rw-hsma-fpga/grub-switch/4_misc/3Dprint_Toggleswitch_Stand_STL/Toggleswitch_stand2.jpg

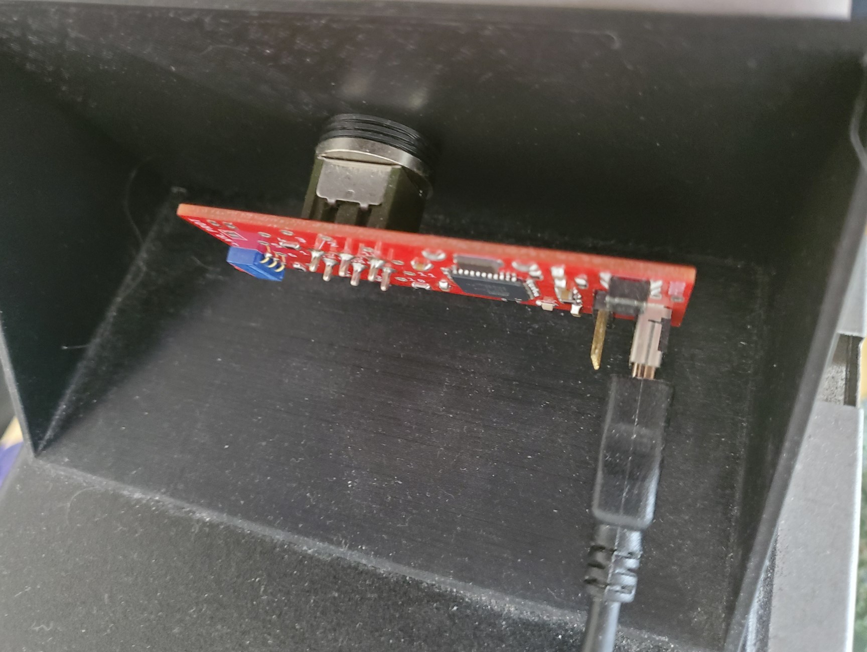
4_misc/3Dprint_Toggleswitch_Stand_STL/Toggleswitch_stand2.jpg
