rw-hsma-fpga/grub-switch/4_misc/ArduinoMicro_Toggleswitch_Fritzing/ArduinoMicro_Toggleswitch_Fritzing.png

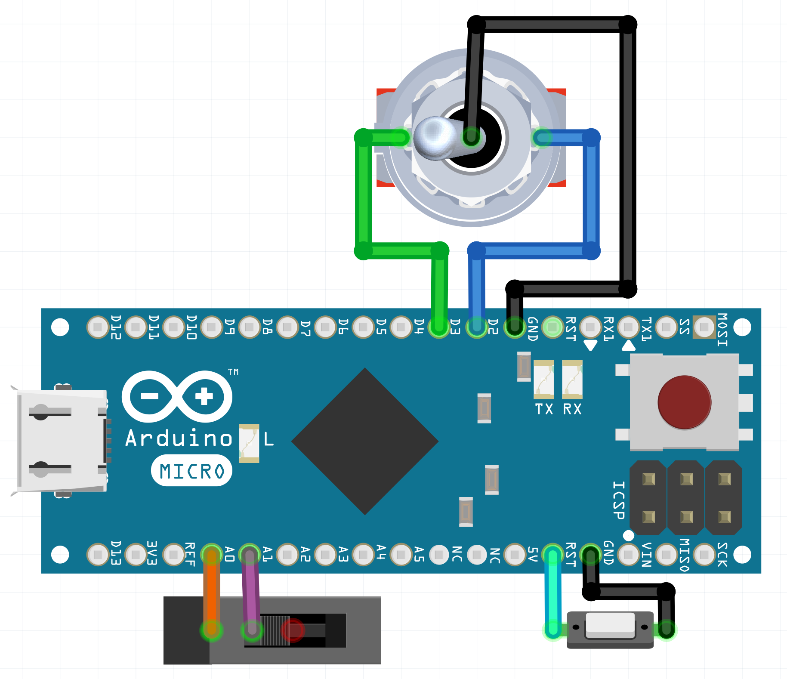
4_misc/ArduinoMicro_Toggleswitch_Fritzing/ArduinoMicro_Toggleswitch_Fritzing.png
