rw-hsma-fpga/grub-switch/4_misc/Lasercut_Case_ProMicro_Toggleswitch_SVG/ProMicro_case2.jpeg

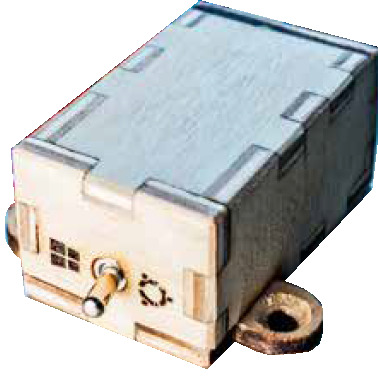
4_misc/Lasercut_Case_ProMicro_Toggleswitch_SVG/ProMicro_case2.jpeg
