rw-hsma-fpga/grub-switch/documentation/src/config_8.png

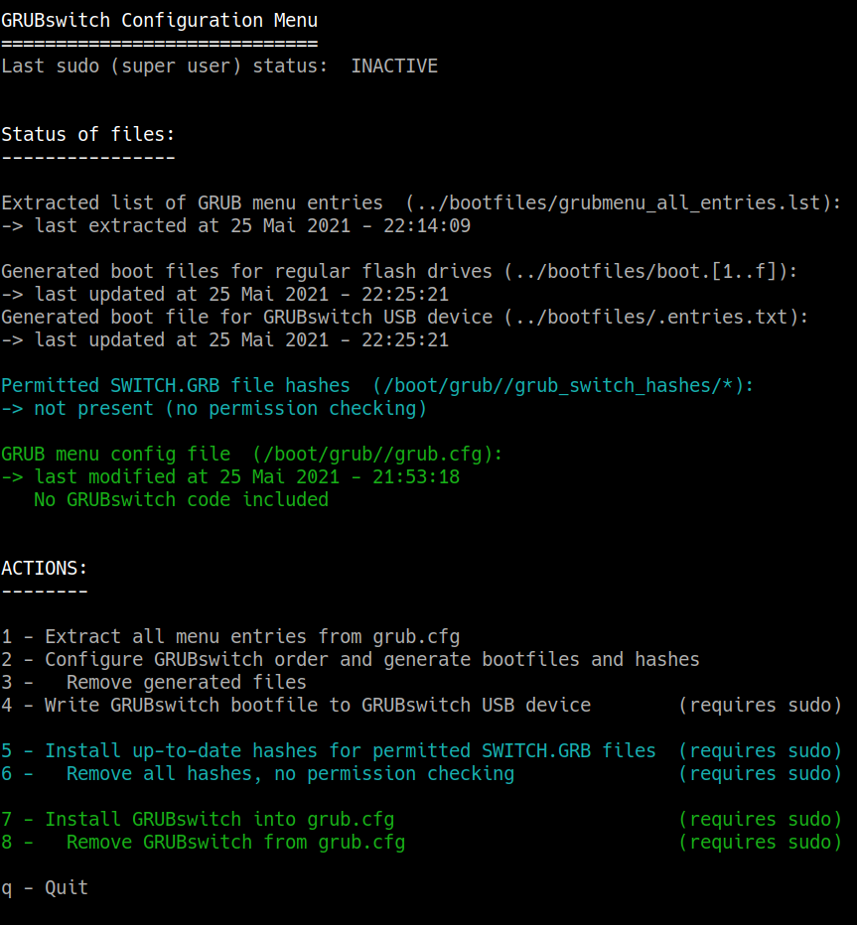
documentation/src/config_8.png
