rw-hsma-fpga/grub-switch/documentation/src/config_10.png

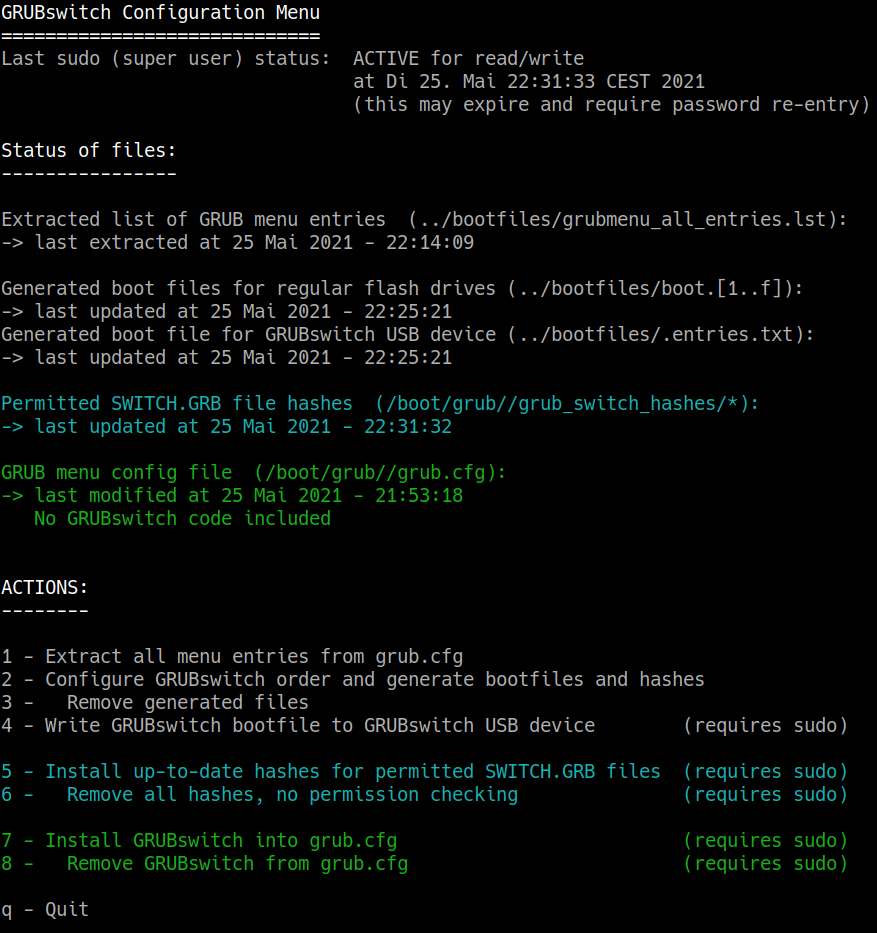
documentation/src/config_10.png
