rw-hsma-fpga/grub-switch/documentation/src/custom_hw_revb_bottom.png

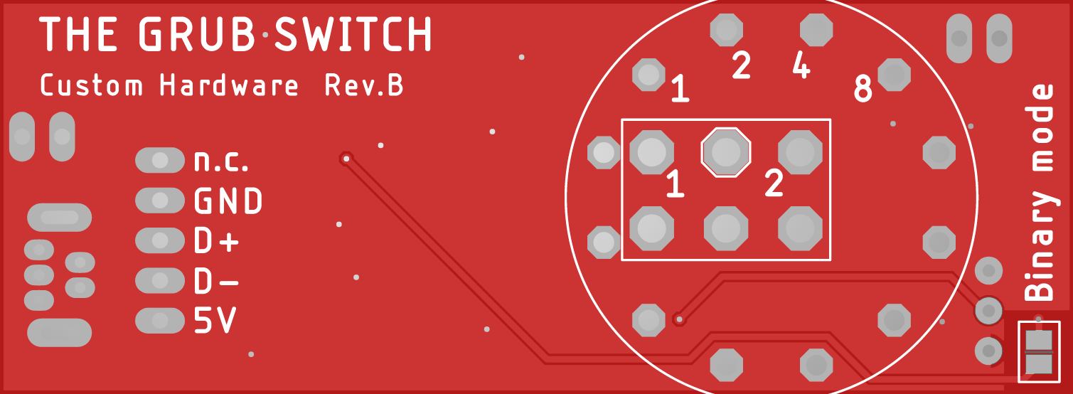
documentation/src/custom_hw_revb_bottom.png
