rw-hsma-fpga/grub-switch/documentation/src/custom_hw_revc_passives_top.png

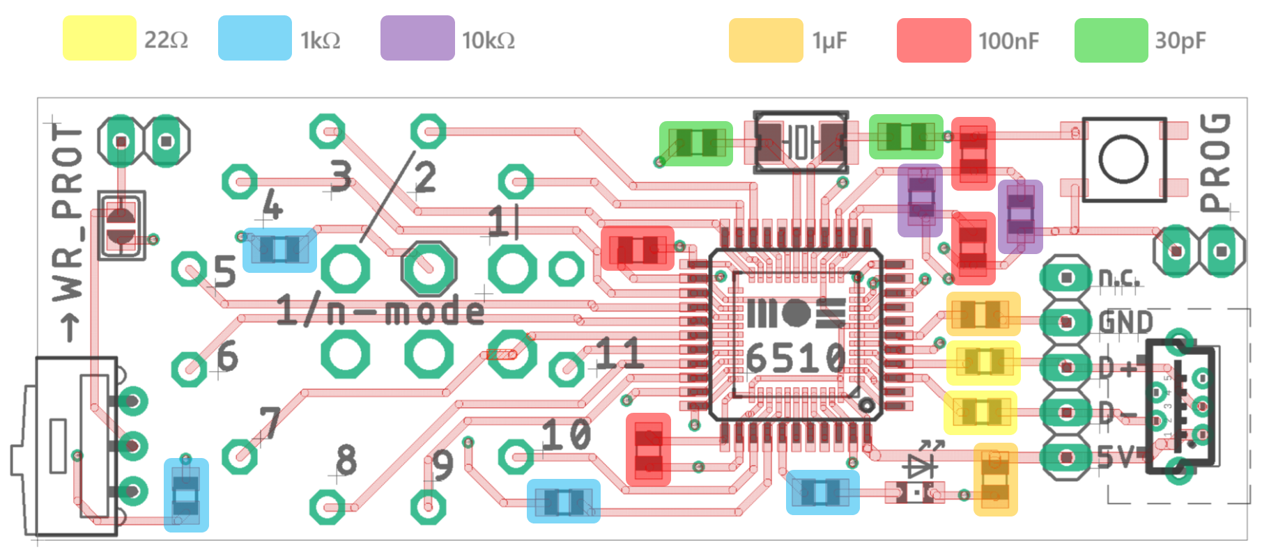
documentation/src/custom_hw_revc_passives_top.png
