rw-hsma-fpga/grub-switch/documentation/src/passives_top.png

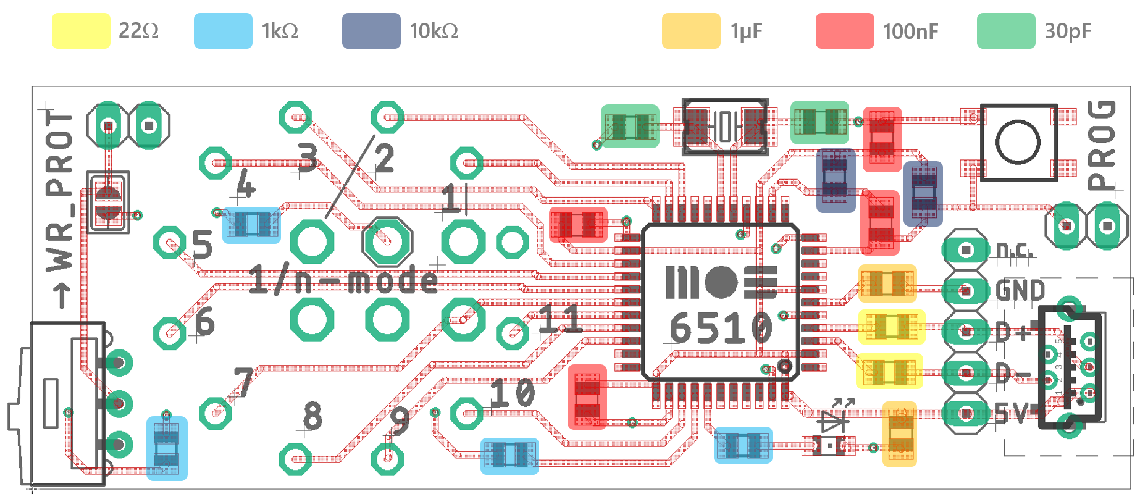
documentation/src/passives_top.png
