rw-hsma-fpga/grub-switch/documentation/src/rotary_sw_bottom.png

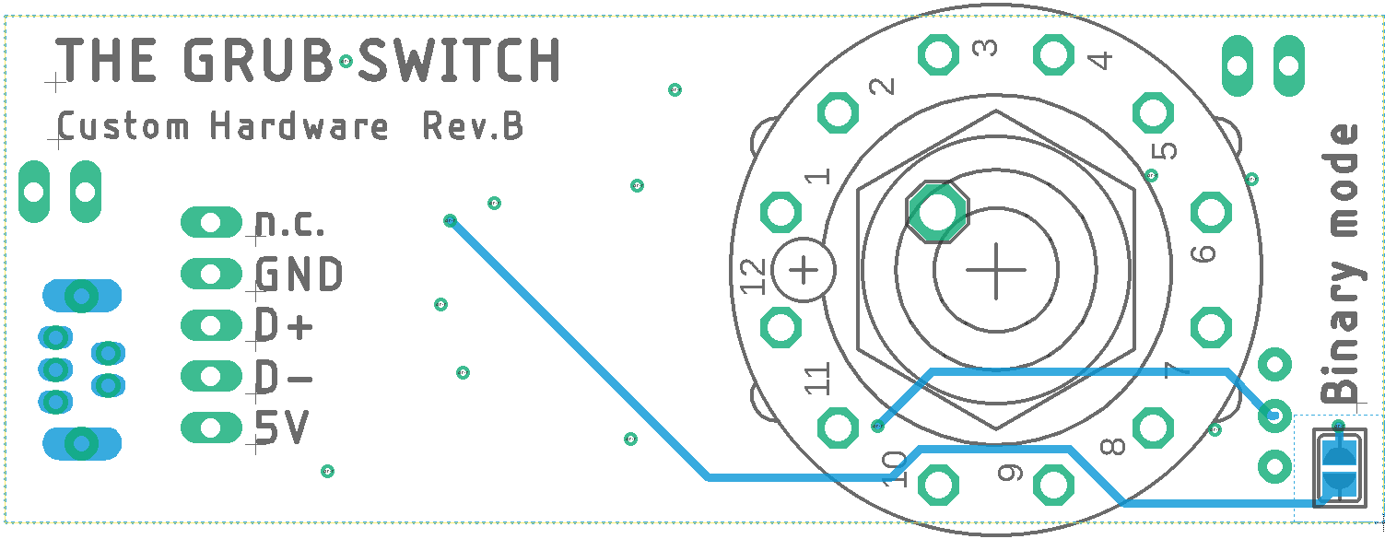
documentation/src/rotary_sw_bottom.png
