rw-hsma-fpga/grub-switch/documentation/src/toggle_sw_bottom.png

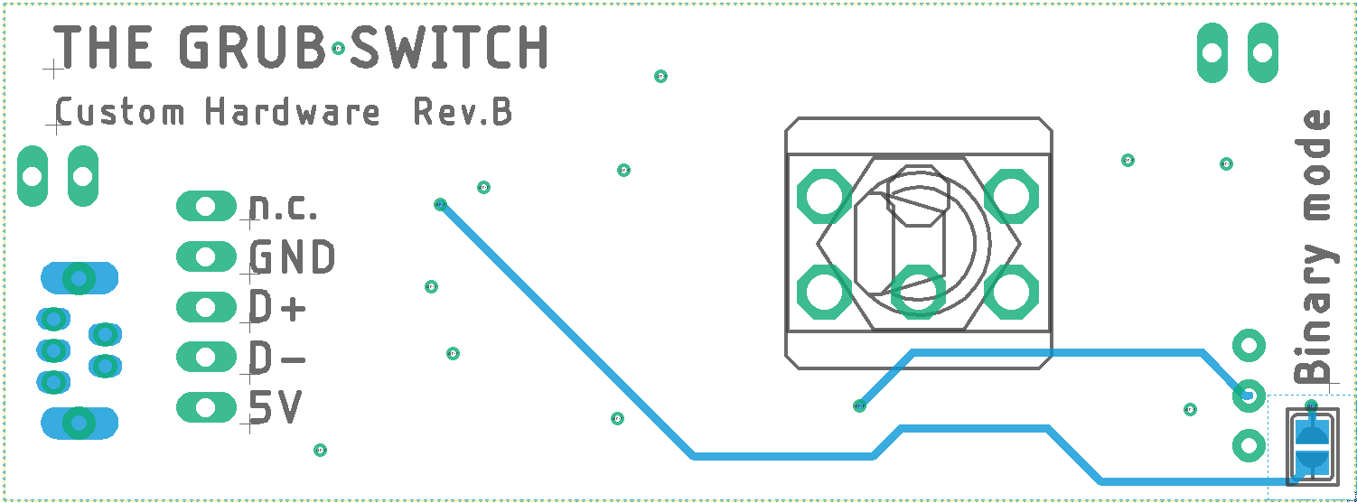
documentation/src/toggle_sw_bottom.png
