rw-hsma-fpga/grub-switch/4_misc/3Dprint_Toggleswitch_Stand_STL/Toggleswitch_stand.stl

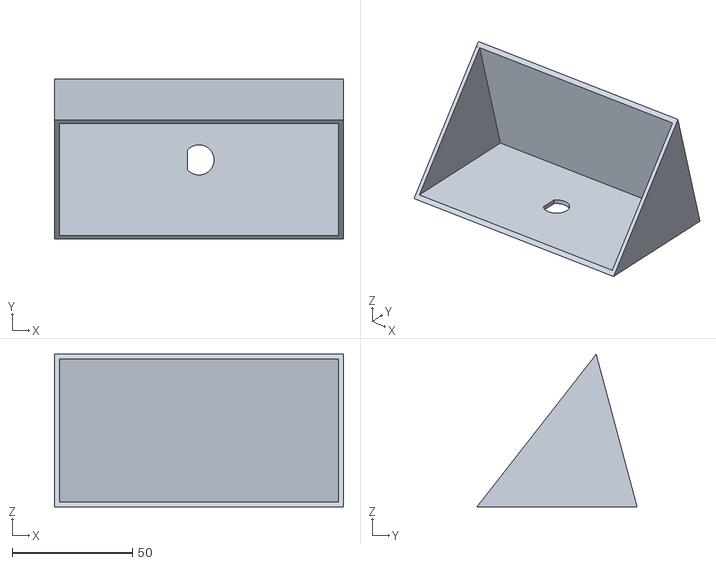
[picture p30: CAD file, 2023-05-13]
4_misc/3Dprint_Toggleswitch_Stand_STL/Toggleswitch_stand.stl
120.0 x 66.5 x 63.4
