rw-hsma-fpga/grub-switch/4_misc/3Dprint_Toggleswitch_Stand_STL/Unterlegscheibe_washer.stl

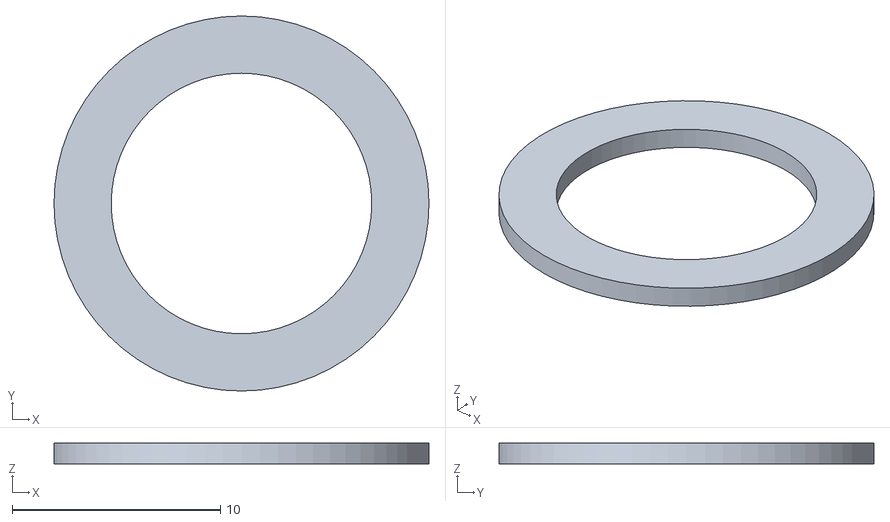
[picture p31: CAD file, 2023-05-13]
4_misc/3Dprint_Toggleswitch_Stand_STL/Unterlegscheibe_washer.stl
18.0 x 18.0 x 1.00
