rw-hsma-fpga/grub-switch/documentation/src/RevB_HWB_FIX.png

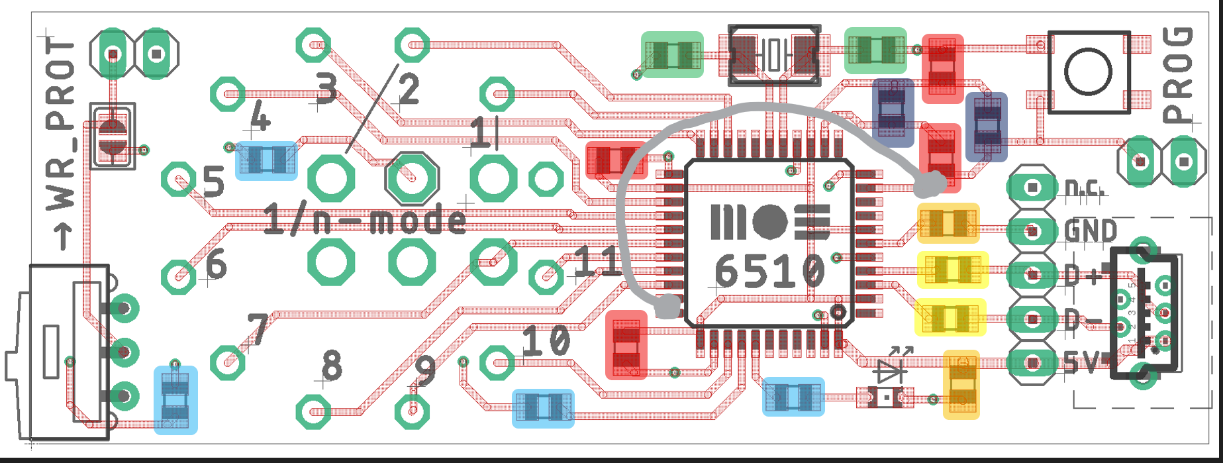
documentation/src/RevB_HWB_FIX.png
