rw-hsma-fpga/grub-switch/(threads)

Thread 1 (2022-12-21):

Only 1 boot entry

joihn, 2022-12-21:
thanks for the repo,
small issue on
` grub-install (GRUB) 2.04-1ubuntu26.15` on ubuntu 20.04,

only 1 boot entry listed by the tool :/

```
Switch positions chosen:
------------------------
0 : GRUB Menu (Fixed)
1 :
2 :
3 :
4 :
5 :
6 :
7 :
8 :
9 :
a :
b :
c :
d :
e :
f :
--------------------------------------------
* Press Enter to confirm selection
* Press Backspace <- to change configuration
* Press q to quit without changes
```

but my `grub customizer` can see many more:
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

I can post my  ```/boot/grub/grub.cfg```   here if needed (don't know if that file contains sensitive info?)

joihn, 2022-12-21:
the entry the tool sis not seeing (among other) is:
```
menuentry "Windows Boot Manager (on /dev/nvme0n1p2)" --class windows --class os $menuentry_id_option 'osprober-efi-403C-EC14' {
	insmod part_gpt
	insmod fat
	if [ x$feature_platform_search_hint = xy ]; then
	  search --no-floppy --fs-uuid --set=root  403C-EC14
	else
	  search --no-floppy --fs-uuid --set=root 403C-EC14
	fi
	chainloader /EFI/Microsoft/Boot/bootmgfw.efi
}
```

joihn, 2022-12-21:
the entry the tool is seeing:
```
menuentry 'UEFI Firmware Settings' $menuentry_id_option 'uefi-firmware' {
	fwsetup
}
```

rw-hsma-fpga, 2023-03-08:
Apologies, totally missed this issue post. Changed my notification settings now and hope that doesn't happen again.

Figuring out things by email with the original poster now and putting the solution here when we've figured it out.

rw-hsma-fpga, 2023-03-11:
Appears to be fixed in most recent commit [e8f9b73](https://github.com/rw-hsma-fpga/grub-switch/commit/e8f9b737731c96dc34d488b824cdf55009a5e23b).

The regular expression in the **grub.cfg** parser was only looking for titles between apostrophes/ticks, but some versions of **os-prober** apparently produce them with quotes. RegEx is extended now.

Also apparently, there does not need to be a space between a submenu title and the opening bracket:

    submenu "Advanced Ubuntu options"{

so removed that condition from the RegEx too.

Closed 2023-03-11.

Thread 3 (2024-10-25):

grub switch bypassed if last booted OS was linux

joihn, 2024-10-25:
thanks for this tool.
I use if to switch between my windows10/ubuntu22 with a arduino pro micro.
however, the tools only work partially.
# work well
if the last os booted was window (windows was on, computer is shutdown, computer is started),
then the tools correctly read signal from the arduino pro micro and boot the correct os

# does not work
if the last os booted was ubuntu (ubuntu was on, computer is shutdown, computer is started),
then the computer goes directly to "normal" grub, with a list of entries to boot appear.
it seems in this scenarion grub switcher is bypassed entirely, and of course does not read signal from the pro micro

I would be happy to provide more logs if hinted

joihn, 2024-10-29:
tweaking bios boot priority solved the issue

Closed 2024-10-29.
