rw-hsma-fpga/grub-switch/3_custom_hardware/eagle_files/GRUBswitch_CustomHW_RevC_schematic.pdf

# GND⁺⁵V

C7 | C8 ¹ ³⁴ ² | R⁵

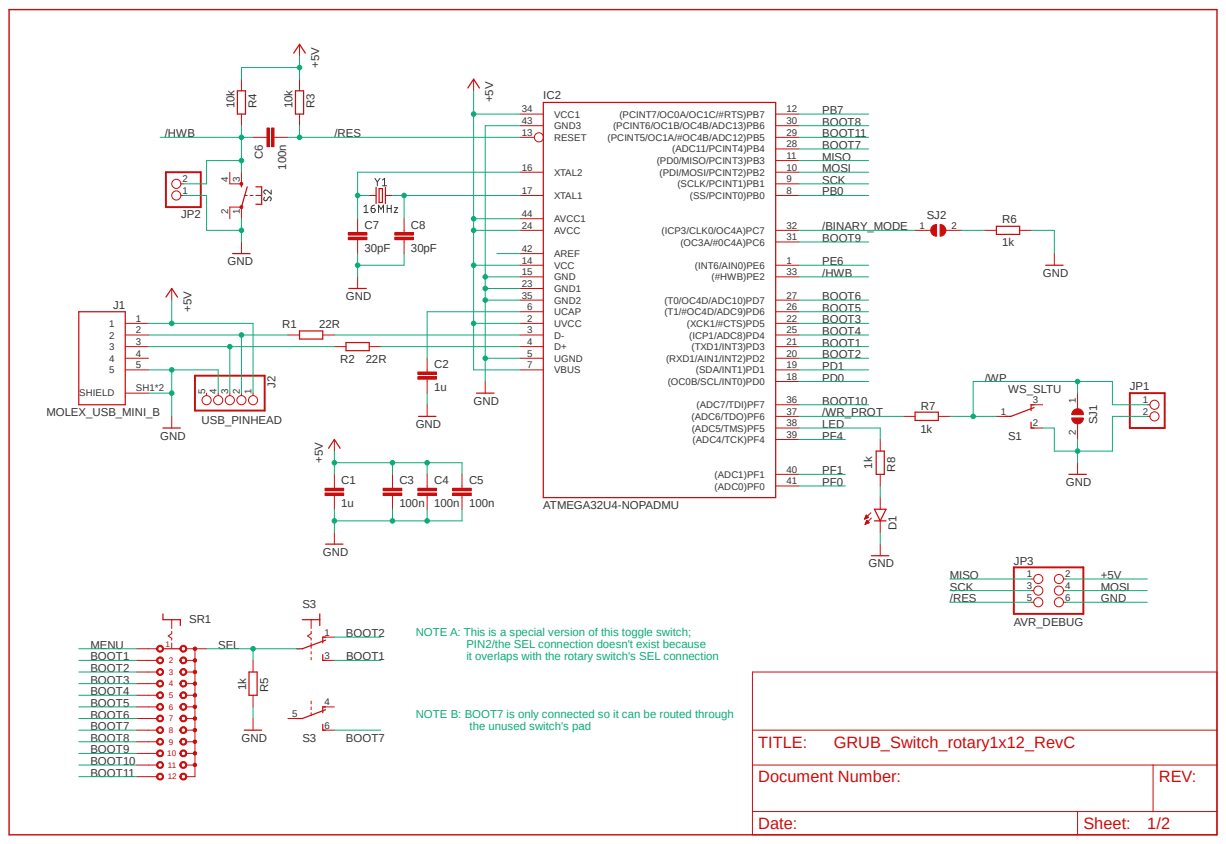
[picture p33: page 1]

AVCC 24 AVCC1 44

AREF 42 VCC 14

GND 15

4 5 | UGND 5

NOTE A: This is a special version of this toggle switch;

PIN2/the SEL connection doesn't exist because
it overlaps with the rotary switch's SEL connection

NOTE B: BOOT7 is only connected so it can be routed through

the unused switch's pad

Document Number: | REV:

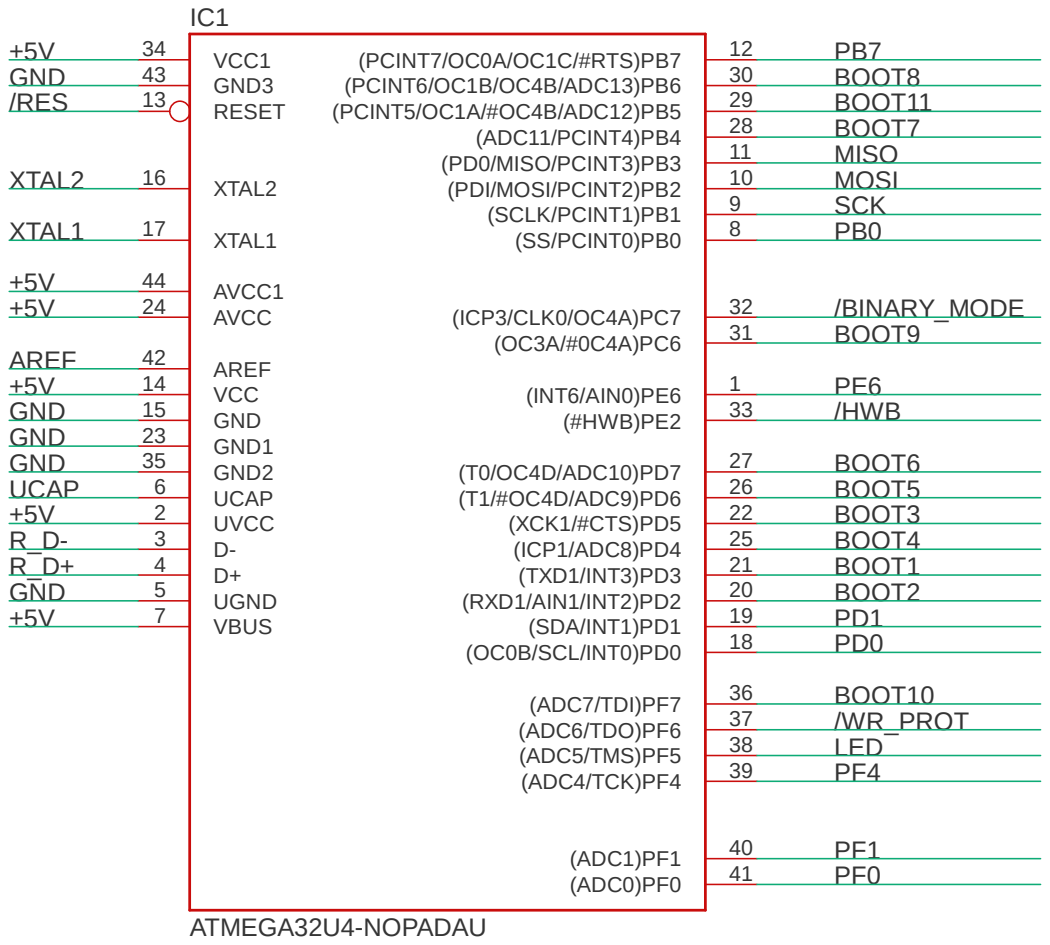
[picture p34: page 2]
ATMEGA32U4-NOPADAU; (#HWB)PE2; (ADC0)PF0; 41 (ADC1)PF1; (ADC4/TCK)PF4; 39 (ADC5/TMS)PF5; 38 (ADC6/TDO)PF6; 37 (ADC7/TDI)PF7; (ADC11/PCINT4)PB4; (ICP1/ADC8)PD4; (ICP3/CLK0/OC4A)PC7; (INT6/AIN0)PE6; (OC0B/SCL/INT0)PD0; (PCINT5/OC1A/#OC4B/ADC12)PB5; 29 (PCINT6/OC1B/OC4B/ADC13)PB6; 30 (PCINT7/OC0A/OC1C/#RTS)PB7; (PD0/MISO/PCINT3)PB3; (PDI/MOSI/PCINT2)PB2; (RXD1/AIN1/INT2)PD2; (SCLK/PCINT1)PB1; (SDA/INT1)PD1; (SS/PCINT0)PB0; (T0/OC4D/ADC10)PD7; (T1/#OC4D/ADC9)PD6; (TXD1/INT3)PD3; (XCK1/#CTS)PD5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

Document Number: | REV:

Date: 26.06.2022 21:38 | Sheet: 2/2
