rw-hsma-fpga/grub-switch/3_custom_hardware/eagle_files/GRUBswitch_CustomHW_RevC_board_bottom.pdf

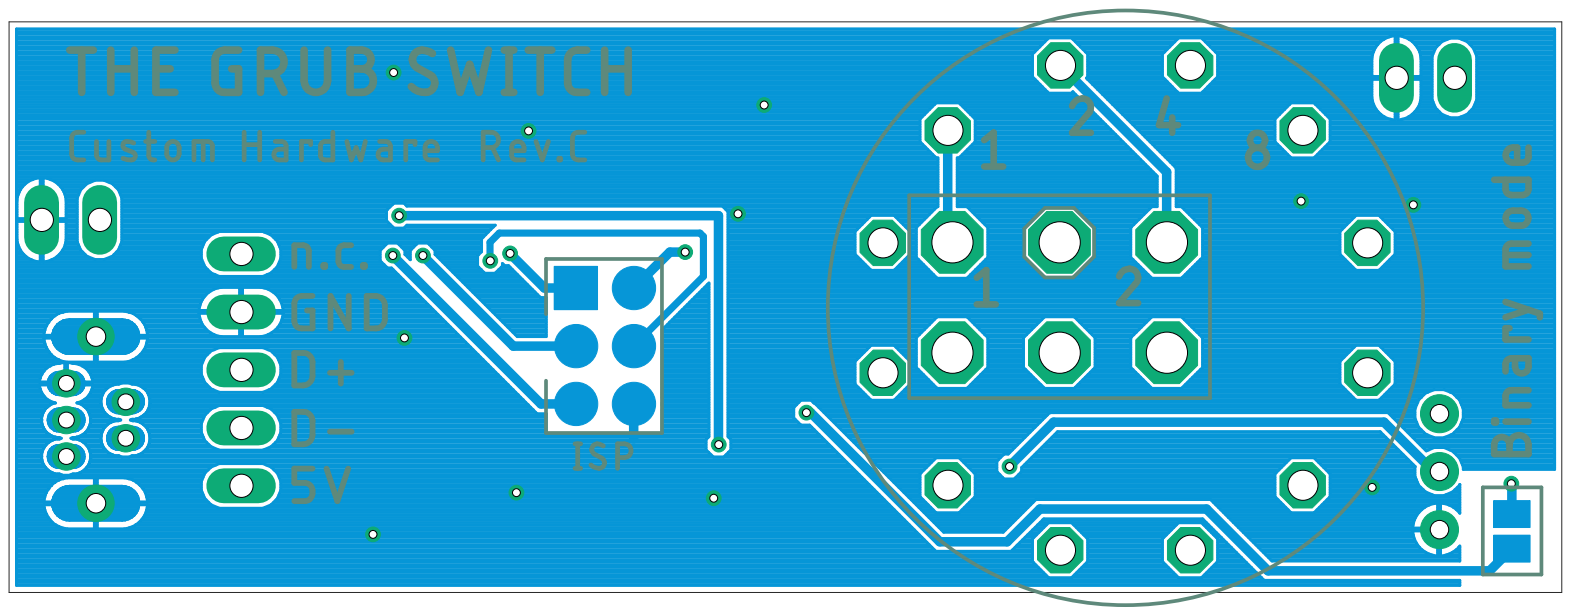
[picture p35: page 1]
