rw-hsma-fpga/grub-switch/3_custom_hardware/eagle_files/GRUBswitch_CustomHW_RevC_board_top.pdf

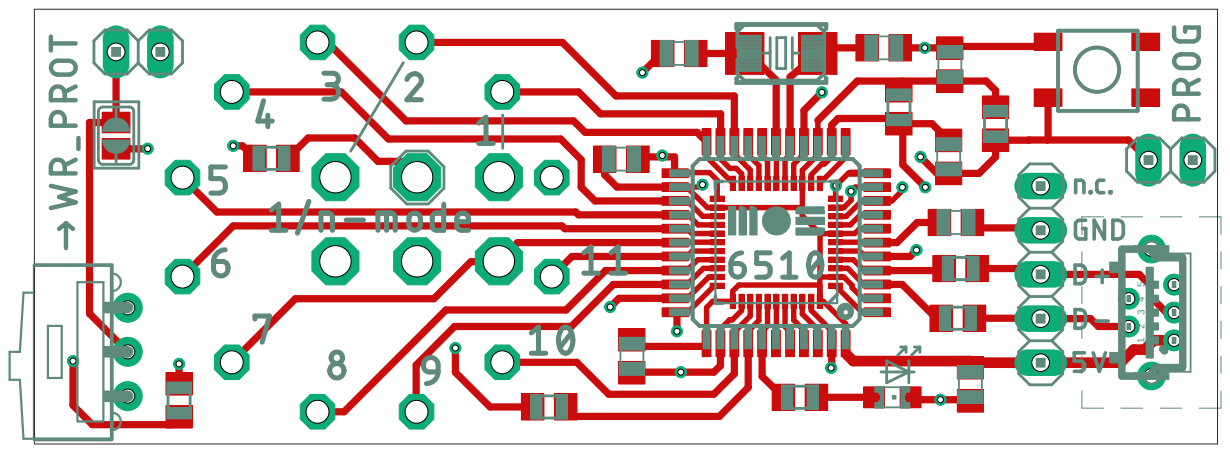
[picture p36: page 1]
