rw-hsma-fpga/grub-switch/3_custom_hardware/_legacy_RevB/eagle_files/GRUBswitch_CustomHW_RevB_board_bottom.pdf

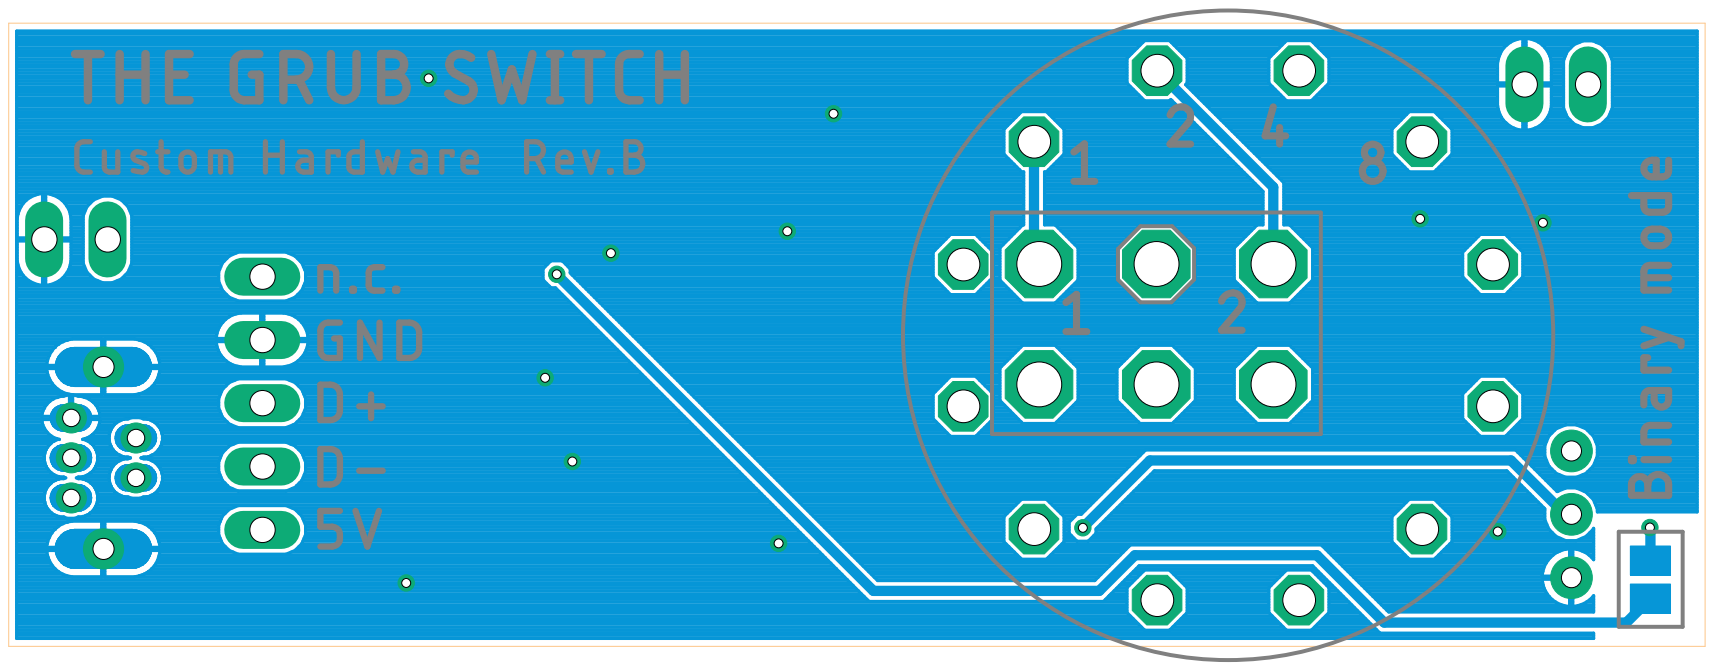
[picture p37: page 1]
