rw-hsma-fpga/grub-switch/3_custom_hardware/_legacy_RevB/eagle_files/GRUBswitch_CustomHW_RevB_board_top.pdf

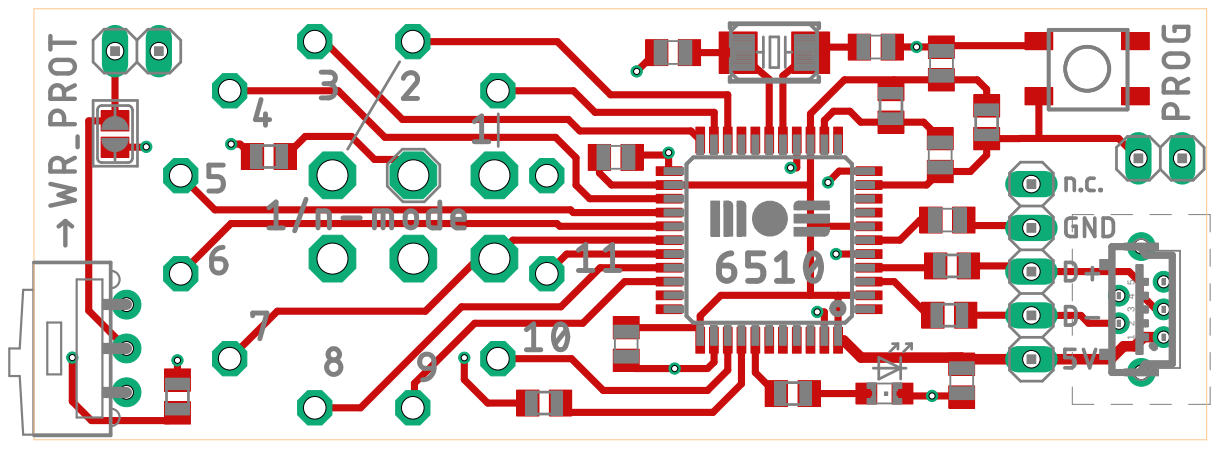
[picture p38: page 1]
