rw-hsma-fpga/grub-switch/(list of files, drawings)

Other design files:
4_misc/ArduinoMicro_Toggleswitch_Fritzing/ArduinoMicro_Toggleswitch_Fritzing.fzz
