rw-hsma-fpga/grub-switch/3_custom_hardware/eagle_files/GRUBswitch_CustomHW_RevC.brd

## EAGLE design 3_custom_hardware/eagle_files/GRUBswitch_CustomHW_RevC.brd (2022-06-27)

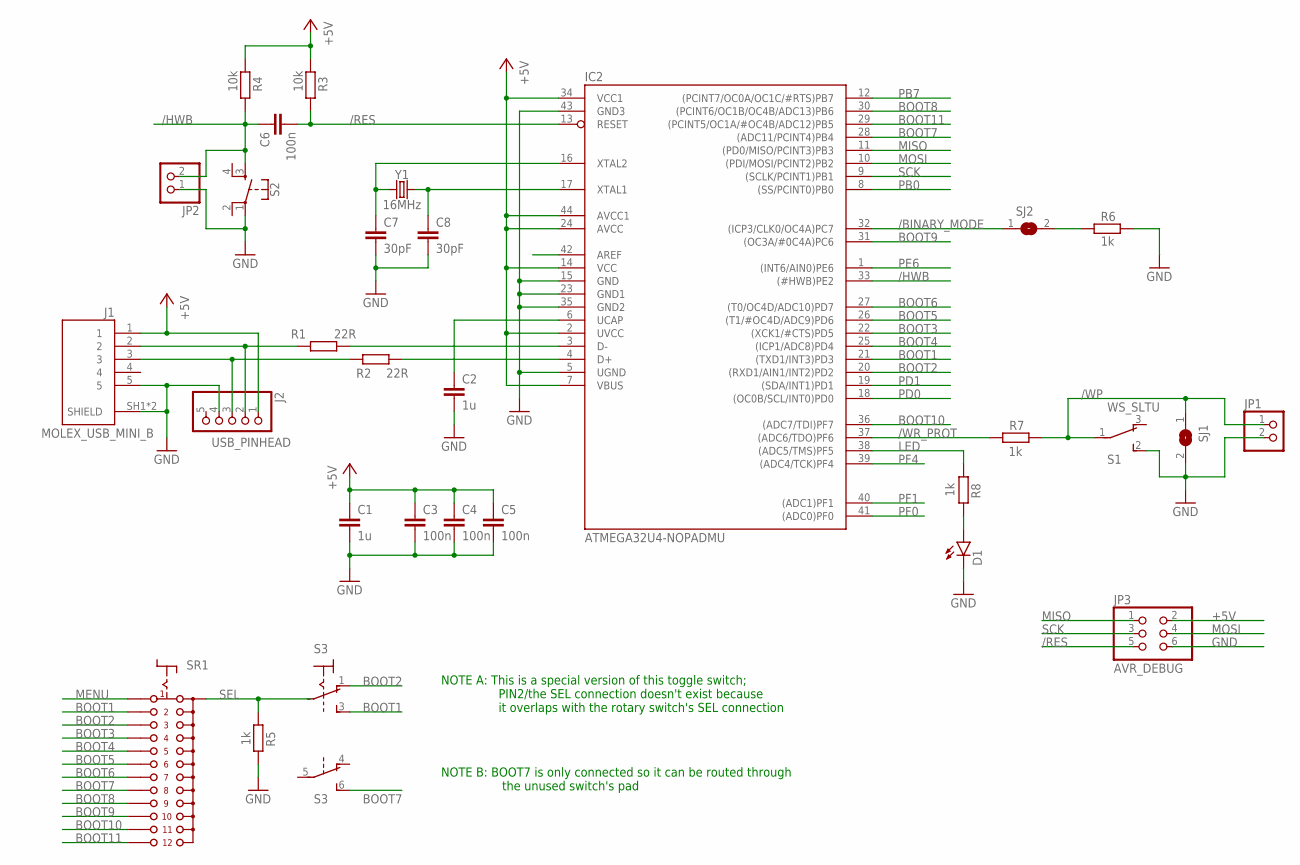
[picture p39: schematic GRUBswitch_CustomHW_RevC.sch, sheet 1]

Parts:
C1, C2: 1u; C0805
C3, C4, C5, C6: 100n; C0805
C7, C8: 30pF; C0805
D1: LEDCHIPLED_0805; CHIPLED_0805
IC2: ATMEGA32U4-NOPADMU; QFN-44-NOPAD
J1: MOLEX_USB_MINI_B; MOLEX_502237-0517
J2: USB_PINHEAD; 1X05
JP1, JP2: PINHD-1X2; 1X02
JP3: AVR_DEBUG; 2X03_SMD
R1, R2: 22R; R0805
R3, R4: 10k; R0805
R5, R6, R7, R8: 1k; R0805
S1: WS_SLTU
S2: MOMENTARY-SWITCH-SPST-2-SMD-4.5MM; TACTILE_SWITCH_SMD_4.5MM
S3: M9040P2
SJ1, SJ2: SJ
SR1: CK101X12+
Y1: 16MHz; CRYSTAL-SMD-5X3.2-2PAD

Connections:
+5V: C1.1, C3.1, C4.1, C5.1, IC2.2 (UVCC), IC2.7 (VBUS), IC2.14 (VCC), IC2.24 (AVCC), IC2.34 (VCC1), IC2.44 (AVCC1), J1.1, J2.1, JP3.2, R3.2, R4.2; also elsewhere on the board
/BINARY_MODE: IC2.32 ((ICP3/CLK0/OC4A)PC7), SJ2.1; also elsewhere on the board
/BM: R6.1, SJ2.2
/HWB: C6.1, IC2.33 ((#HWB)PE2), JP2.2, R4.1, S2.3; also elsewhere on the board
/RES: C6.2, IC2.13 (RESET), JP3.5, R3.1; also elsewhere on the board
/WP: JP1.1, R7.1, S1.1, SJ1.1
/WR_PROT: IC2.37 ((ADC6/TDO)PF6), R7.2; also elsewhere on the board
AREF: IC2.42 (AREF); also elsewhere on the board
BOOT1: IC2.21 ((TXD1/INT3)PD3), S3.3 (S), SR1.2; also elsewhere on the board
BOOT2: IC2.20 ((RXD1/AIN1/INT2)PD2), S3.1 (O), SR1.3; also elsewhere on the board
BOOT3: IC2.22 ((XCK1/#CTS)PD5), SR1.4; also elsewhere on the board
BOOT4: IC2.25 ((ICP1/ADC8)PD4), SR1.5; also elsewhere on the board
BOOT5: IC2.26 ((T1/#OC4D/ADC9)PD6), SR1.6; also elsewhere on the board
BOOT6: IC2.27 ((T0/OC4D/ADC10)PD7), SR1.7; also elsewhere on the board
BOOT7: IC2.28 ((ADC11/PCINT4)PB4), S3.6 (S), SR1.8; also elsewhere on the board
BOOT8: IC2.30 ((PCINT6/OC1B/OC4B/ADC13)PB6), SR1.9; also elsewhere on the board
BOOT9: IC2.31 ((OC3A/#0C4A)PC6), SR1.10; also elsewhere on the board
BOOT10: IC2.36 ((ADC7/TDI)PF7), SR1.11; also elsewhere on the board
BOOT11: IC2.29 ((PCINT5/OC1A/#OC4B/ADC12)PB5), SR1.12; also elsewhere on the board
D+: J1.3, J2.3, R2.1
D-: J1.2, J2.2, R1.1
GND: C1.2, C2.2, C3.2, C4.2, C5.2, C7.2, C8.2, D1.C, IC2.5 (UGND), IC2.15 (GND), IC2.23 (GND1), IC2.35 (GND2), IC2.43 (GND3), J1.5, J1.SH1 (SHIELD), J1.SH2 (SHIELD), J2.4, JP1.2, JP2.1, JP3.6, R5.2, R6.2, S1.2 (S), S2.1, SJ1.2; also elsewhere on the board
LED: IC2.38 ((ADC5/TMS)PF5), R8.2; also elsewhere on the board
MENU: SR1.1
MISO: IC2.11 ((PD0/MISO/PCINT3)PB3), JP3.1; also elsewhere on the board
MOSI: IC2.10 ((PDI/MOSI/PCINT2)PB2), JP3.4; also elsewhere on the board
unnamed: D1.A, R8.1
PB0: IC2.8 ((SS/PCINT0)PB0); also elsewhere on the board
PB7: IC2.12 ((PCINT7/OC0A/OC1C/#RTS)PB7); also elsewhere on the board
PD0: IC2.18 ((OC0B/SCL/INT0)PD0); also elsewhere on the board
PD1: IC2.19 ((SDA/INT1)PD1); also elsewhere on the board
PE6: IC2.1 ((INT6/AIN0)PE6); also elsewhere on the board
PF0: IC2.41 ((ADC0)PF0); also elsewhere on the board
PF1: IC2.40 ((ADC1)PF1); also elsewhere on the board
PF4: IC2.39 ((ADC4/TCK)PF4); also elsewhere on the board
R_D+: IC2.4 (D+), R2.2; also elsewhere on the board
R_D-: IC2.3 (D-), R1.2; also elsewhere on the board
SCK: IC2.9 ((SCLK/PCINT1)PB1), JP3.3; also elsewhere on the board
SEL: R5.1, SR1.A
UCAP: C2.1, IC2.6 (UCAP); also elsewhere on the board
XTAL1: C8.1, IC2.17 (XTAL1), Y1.P$2 (2); also elsewhere on the board
XTAL2: C7.1, IC2.16 (XTAL2), Y1.P$1 (1); also elsewhere on the board

Notes on the sheet:
NOTE A: This is a special version of this toggle switch; PIN2/the SEL connection doesn't exist because it overlaps with the rotary switch's SEL connection
NOTE B: BOOT7 is only connected so it can be routed through the unused switch's pad

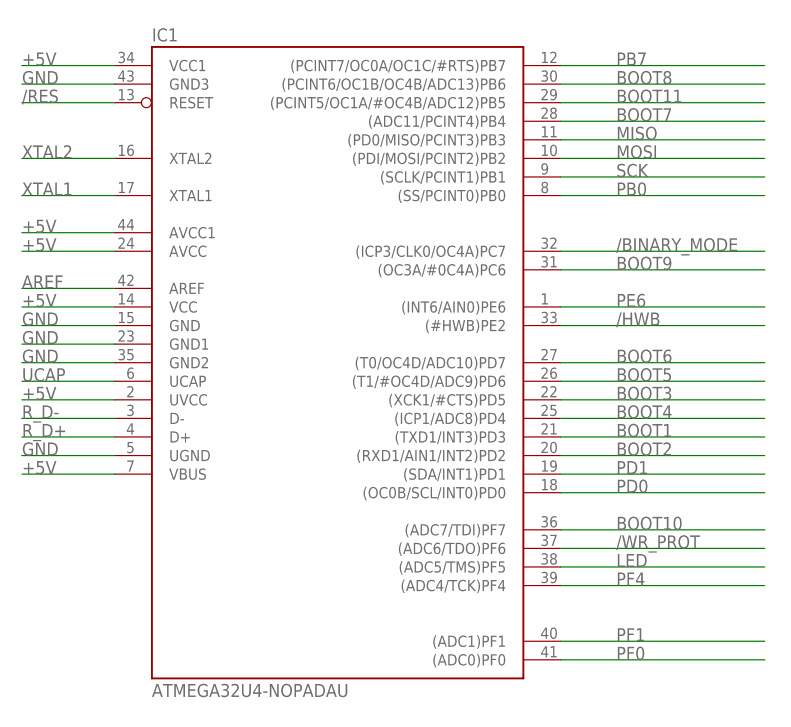
[picture p40: schematic GRUBswitch_CustomHW_RevC.sch, sheet 2]

Parts:
IC1: ATMEGA32U4-NOPADAU; TQFP44

Connections:
+5V: IC1.2 (UVCC), IC1.7 (VBUS), IC1.14 (VCC), IC1.24 (AVCC), IC1.34 (VCC1), IC1.44 (AVCC1); also elsewhere on the board
/BINARY_MODE: IC1.32 ((ICP3/CLK0/OC4A)PC7); also elsewhere on the board
/HWB: IC1.33 ((#HWB)PE2); also elsewhere on the board
/RES: IC1.13 (RESET); also elsewhere on the board
/WR_PROT: IC1.37 ((ADC6/TDO)PF6); also elsewhere on the board
AREF: IC1.42 (AREF); also elsewhere on the board
BOOT1: IC1.21 ((TXD1/INT3)PD3); also elsewhere on the board
BOOT2: IC1.20 ((RXD1/AIN1/INT2)PD2); also elsewhere on the board
BOOT3: IC1.22 ((XCK1/#CTS)PD5); also elsewhere on the board
BOOT4: IC1.25 ((ICP1/ADC8)PD4); also elsewhere on the board
BOOT5: IC1.26 ((T1/#OC4D/ADC9)PD6); also elsewhere on the board
BOOT6: IC1.27 ((T0/OC4D/ADC10)PD7); also elsewhere on the board
BOOT7: IC1.28 ((ADC11/PCINT4)PB4); also elsewhere on the board
BOOT8: IC1.30 ((PCINT6/OC1B/OC4B/ADC13)PB6); also elsewhere on the board
BOOT9: IC1.31 ((OC3A/#0C4A)PC6); also elsewhere on the board
BOOT10: IC1.36 ((ADC7/TDI)PF7); also elsewhere on the board
BOOT11: IC1.29 ((PCINT5/OC1A/#OC4B/ADC12)PB5); also elsewhere on the board
GND: IC1.5 (UGND), IC1.15 (GND), IC1.23 (GND1), IC1.35 (GND2), IC1.43 (GND3); also elsewhere on the board
LED: IC1.38 ((ADC5/TMS)PF5); also elsewhere on the board
MISO: IC1.11 ((PD0/MISO/PCINT3)PB3); also elsewhere on the board
MOSI: IC1.10 ((PDI/MOSI/PCINT2)PB2); also elsewhere on the board
PB0: IC1.8 ((SS/PCINT0)PB0); also elsewhere on the board
PB7: IC1.12 ((PCINT7/OC0A/OC1C/#RTS)PB7); also elsewhere on the board
PD0: IC1.18 ((OC0B/SCL/INT0)PD0); also elsewhere on the board
PD1: IC1.19 ((SDA/INT1)PD1); also elsewhere on the board
PE6: IC1.1 ((INT6/AIN0)PE6); also elsewhere on the board
PF0: IC1.41 ((ADC0)PF0); also elsewhere on the board
PF1: IC1.40 ((ADC1)PF1); also elsewhere on the board
PF4: IC1.39 ((ADC4/TCK)PF4); also elsewhere on the board
R_D+: IC1.4 (D+); also elsewhere on the board
R_D-: IC1.3 (D-); also elsewhere on the board
SCK: IC1.9 ((SCLK/PCINT1)PB1); also elsewhere on the board
UCAP: IC1.6 (UCAP); also elsewhere on the board
XTAL1: IC1.17 (XTAL1); also elsewhere on the board
XTAL2: IC1.16 (XTAL2); also elsewhere on the board

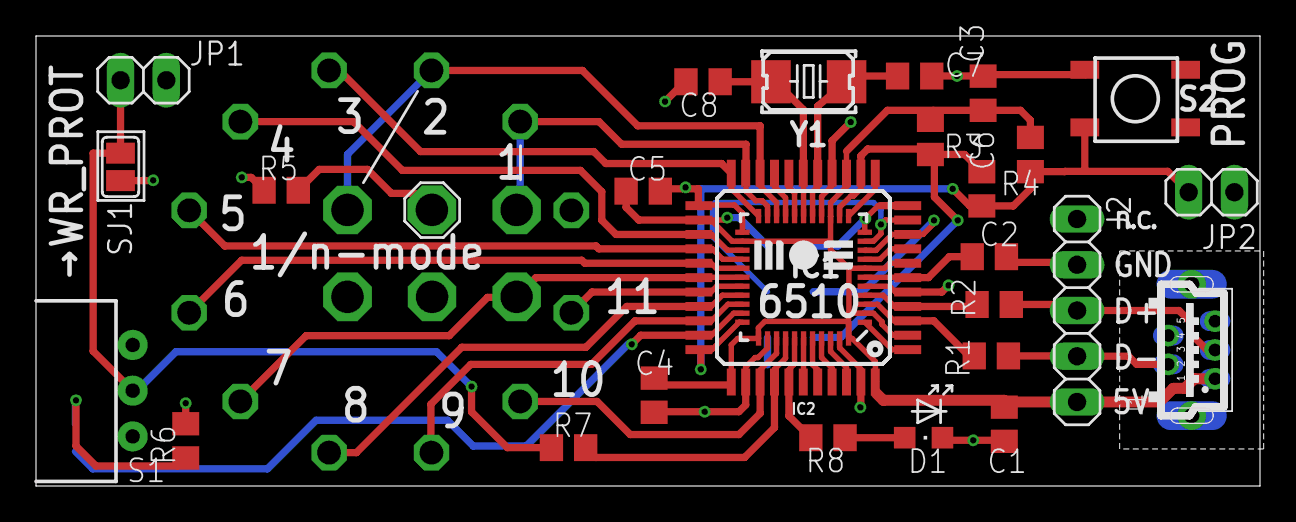
[picture p41: board GRUBswitch_CustomHW_RevC.brd from above]

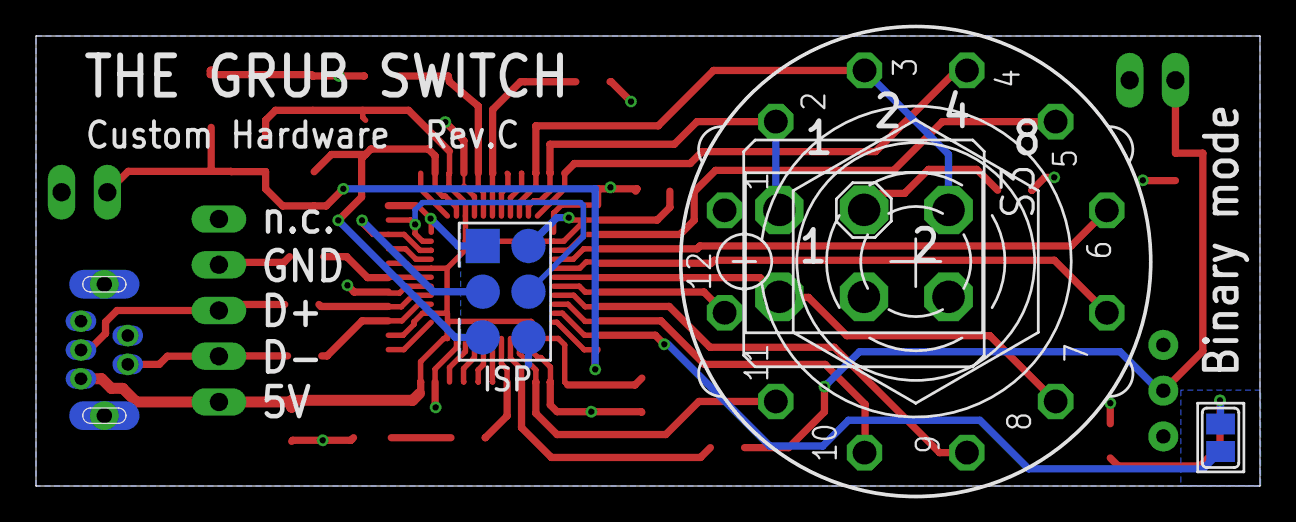
[picture p42: board GRUBswitch_CustomHW_RevC.brd from below]

Board: 2 copper layers, 68.0 x 25.0 mm, 31 parts (4 on the bottom side), 41 nets.
