rw-hsma-fpga/grub-switch/2_usb_device/boards/include/itsybitsy_3v.h

#ifndef ITSYBITSY_3V_H
#define ITSYBITSY_3V_H


#include "config.h"
#ifdef TARGET_BOARD_ITSYBITSY_3V

#define VALID_TARGET_BOARD_DEFINED


// External quartz frequency (kHz) -> CPU core frequency
#define FOSC 8000

#define  LED_PORT           C
#define  LED_PIN            7

#define  MODE_PORT          F
#define  MODE_PIN           1

#define  WRPROT_PORT        F
#define  WRPROT_PIN         6

#define  AUX0_PORT1         F
#define  AUX0_PIN1          7

#define  AUX0_PORT2         F
#define  AUX0_PIN2          0

#define  CHOICE_PORT1       B
#define  CHOICE_PIN1        4

#define  CHOICE_PORT2       D
#define  CHOICE_PIN2        7

#define  CHOICE_PORT3       D
#define  CHOICE_PIN3        4

#define  CHOICE_PORT4       D
#define  CHOICE_PIN4        2

#define  CHOICE_PORT5       D
#define  CHOICE_PIN5        3

#define  CHOICE_PORT6       D
#define  CHOICE_PIN6        1

#define  CHOICE_PORT7       D
#define  CHOICE_PIN7        0

#define  CHOICE_PORT8       E
#define  CHOICE_PIN8        6

#define  CHOICE_PORT9       B
#define  CHOICE_PIN9        5

#define  CHOICE_PORT10      B
#define  CHOICE_PIN10       6

#define  CHOICE_PORT11      B
#define  CHOICE_PIN11       7


#endif   // TARGET_BOARD==ITSYBITSY_3V


#endif   // ITSYBITSY_3V_H
