rw-hsma-fpga/grub-switch/(commit log)

2019-07-31 First commit; usb_device firmware working on Teensy 2.0
2019-07-31 README.md fix; added grub-switch-configure dir
2019-08-06 Script for copying menuentry file to GRUB Switch working
2020-09-17 new development branch for menu shell script
    [grub.cfg]
2020-10-02 Cleaned up board-specific headers; added WR_PROT pin and corresponding write-protect functionality; added Custom HW Grub Switch board
2020-10-26 Changed PID to 2015 (pid.codes); fixed bootpins.ini generation
    [boot_choice.c, boot_choice.h]
2020-10-29 Added ESC to menu to SWITCH.GRB ; added auxiliary low-pin
2020-11-10 Added AUX0 pins, added multiple boards
2020-11-15 Fixed reattach for all pin changes; various board file modifications
    [boards.h, boot_choice.c, promicro_3v.h, promicro_5v.h, storage_task.c, teensy20.h]
2020-11-15 Bootscript change: ESC stops boot but keeps choice.
2021-05-08 Added Master config script; unfinished
    [grub.cfg]
2021-05-12 Renamed usb device folder
2021-05-21 Added DFR Beetle, programming scripts for arduino and DFU
2021-05-24 added wiring info to quickstart.pdf
    [GRUBswitch_CustomHW_RevB.brd, GRUBswitch_CustomHW_RevB.sch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]
2021-05-28 Extended board documentation, minor script fixes
2021-06-14 Started USB device documentation; custom HW BOM enhanced
    [GRUBswitch_CustomHW_RevB_BOM.ods]
2021-06-20 SWITCH.GRB parameters assembled from ROM when read, no SRAM buffer
2021-06-20 Added Custom HW support for ATmega16u4 b/c of chip shortage
    [cf.c, fat12_data.c, fat12_data.h]
2022-06-21 Removed CR from generated SWITCH.GRB; was inconsistent with individual bootfiles and hashes
2022-06-21 Updated prebuilt binaries to current code base
2022-06-23 Added Custom HW Revision C firmware; board documentation to be added
2022-06-27 Updated CustomHW Rev.B BOM with ATmega16U4
    [GRUBswitch_CustomHW_RevB_BOM.ods]
2022-06-27 Moved Custom HW RevB files into legacy folder
    [GRUBswitch_CustomHW_RevB.brd, GRUBswitch_CustomHW_RevB.sch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]
2022-06-27 Updated RevC BOM with MU variants
    [GRUBswitch_CustomHW_RevC_BOM.ods]
2022-08-05 Last switch configuration is read and used
2023-04-22 Added hash generation for empty SWITCH.GRB file
2023-04-29 Updated documentation 0_General_Information with current data
2023-05-13 Added Arduino Leonardo to boards
2023-05-13 Added 4_misc/ with community contributions
    [ArduinoMicro_Toggleswitch_Fritzing.fzz, Toggleswitch_stand.stl, Unterlegscheibe_washer.stl]
