rw-hsma-fpga/grub-switch/(notices)

Notices in the files:
README.md:
License: MIT
